rumbletech/Slug_v1.0/README.md

# Slug_v1.0
Slug ( Slog/Serial Logger ) is an open source firmware and an open source hardware project , it implements logging of serial buses like USART,I2C,SPI to an SD Card.
