rumbletech/Slug_v1.0/kicad/prj/slug_v1_0.kicad_pcb

## KiCad design kicad/prj/slug_v1_0.kicad_pcb (2025-04-25)

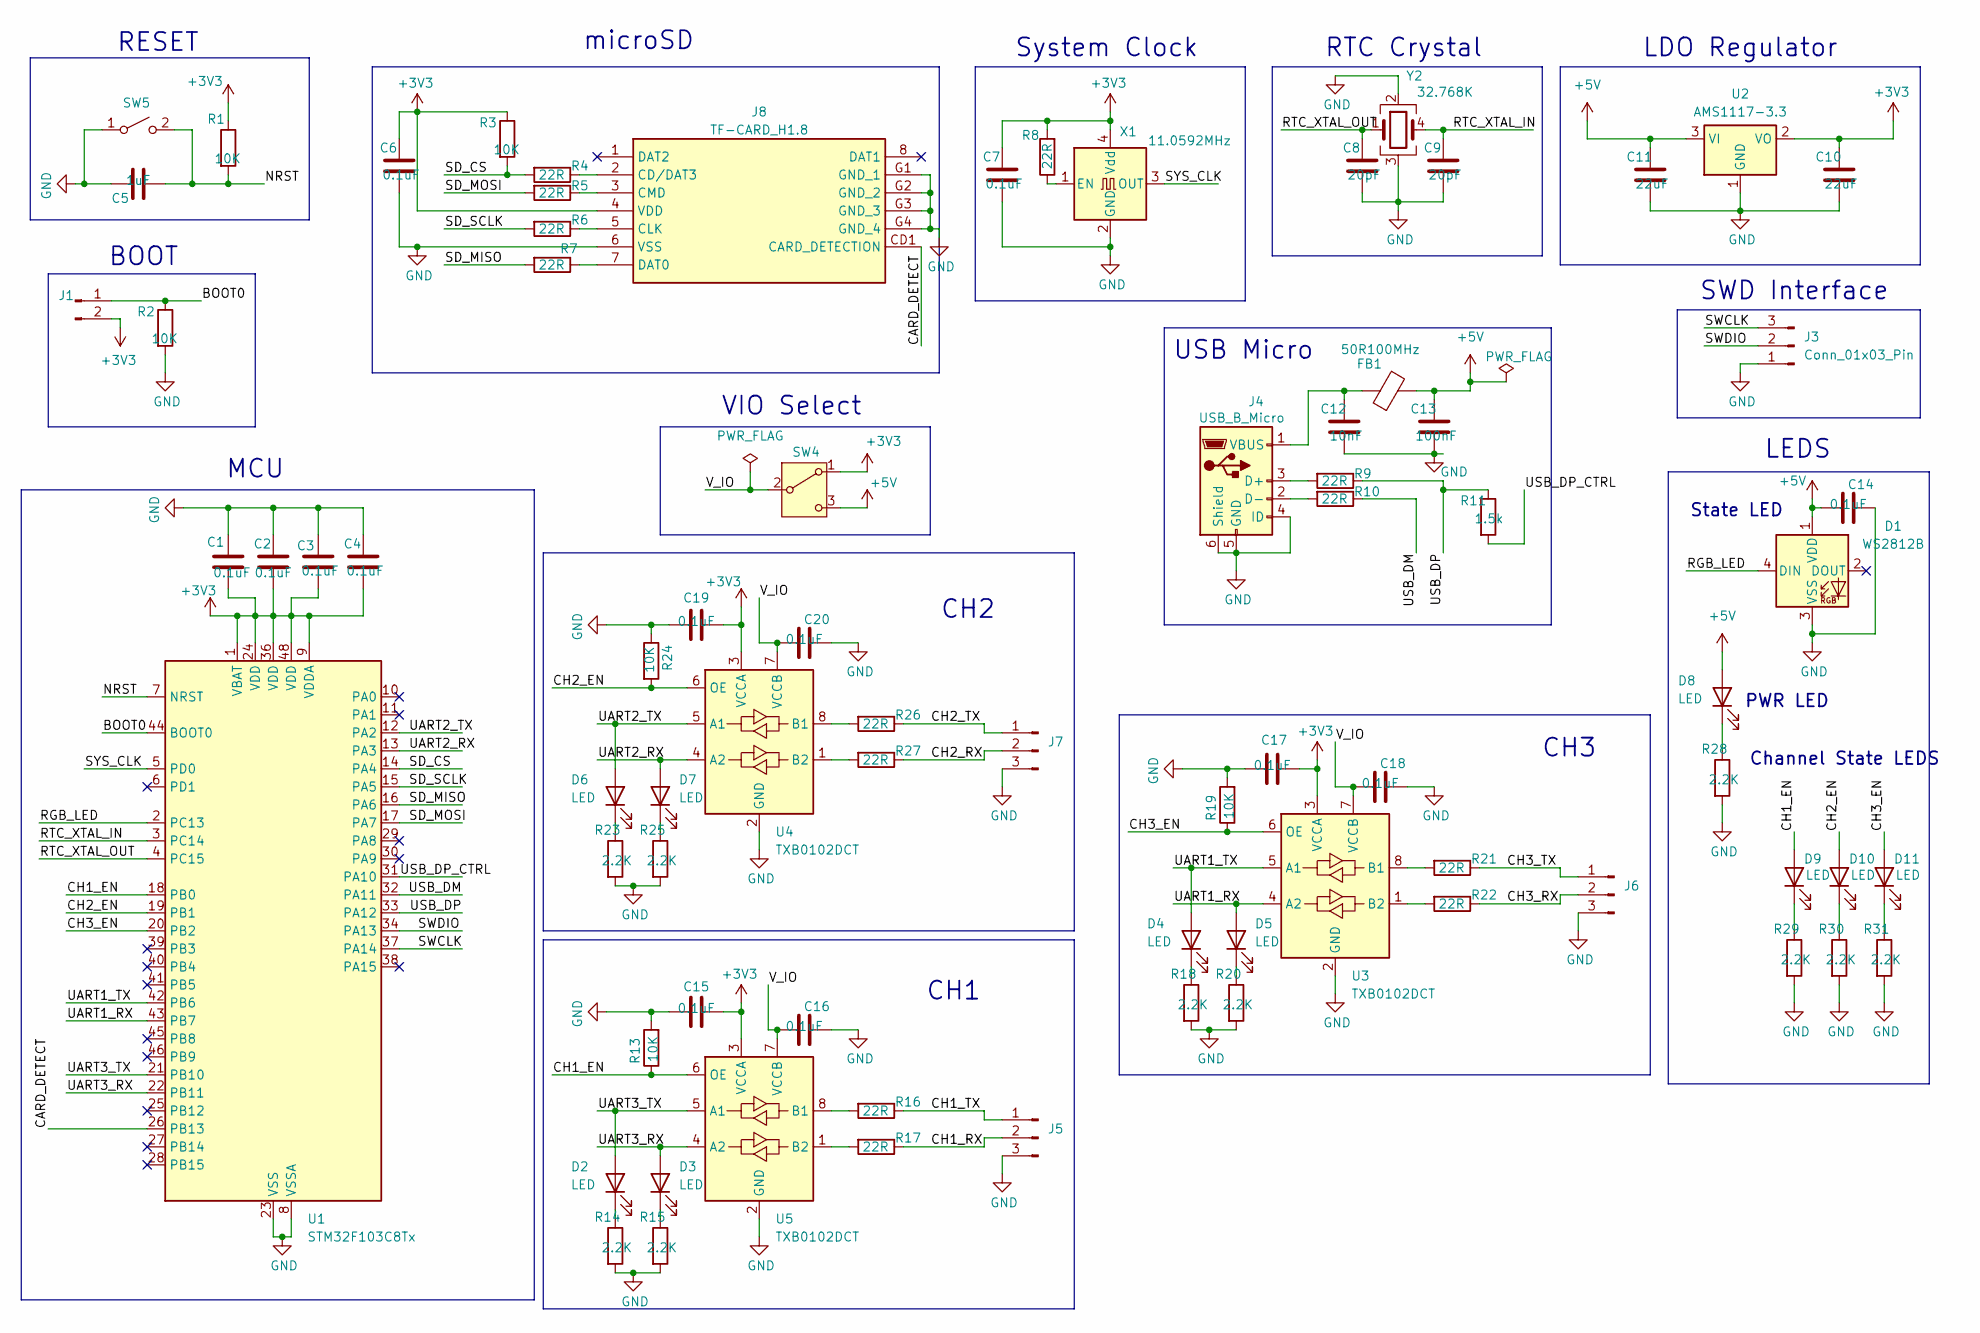
[picture p1: schematic slug_v1_0.kicad_sch]

Parts:
C1, C2, C3, C4, C6, C7, C14, C15, C16, C17, C18, C19, C20: 0.1uF; C_0805_2012Metric
C5: 1uF; C_0805_2012Metric
C8, C9: 20pF; C_0805_2012Metric
C10, C11: 22uF; C_0805_2012Metric
C12: 10nF; C_0805_2012Metric
C13: 100nF; C_0805_2012Metric
D1: WS2812B; LED_WS2812B_PLCC4_5.0x5.0mm_P3.2mm
D2, D3, D4, D5, D6, D7, D8, D9, D10, D11: LED; LED_0805_2012Metric
FB1: 50R100MHz; L_0805_2012Metric
J1: Conn_01x02_Pin; PinHeader_1x02_P2.54mm_Vertical
J3: Conn_01x03_Pin; PinHeader_1x03_P2.54mm_Vertical
J4: USB_B_Micro; USB_Micro-B_Amphenol_10118193-0001LF_Horizontal
J5, J6, J7: Conn_01x03_Pin; PinHeader_1x03_P2.54mm_Horizontal
J8: TF-CARD_H1.8; TFCARDH18; Manufacturer_Part_Number TF-CARD H1.8
R1, R2, R3, R13, R19, R24: 10K; R_0805_2012Metric
R4, R5, R6, R7, R8, R9, R10, R16, R17, R21, R22, R26, R27: 22R; R_0805_2012Metric
R11: 1.5k; R_0805_2012Metric
R14, R15, R18, R20, R23, R25, R28, R29, R30, R31: 2.2K; R_0805_2012Metric
SW4: SW_SPDT; SW_SPDT_CK_JS102011SAQN
SW5: SW_SPST; SW_SPST_SKQG_WithStem
U1: STM32F103C8Tx; LQFP-48_7x7mm_P0.5mm
U2: AMS1117-3.3; SOT-223-3_TabPin2
U3, U4, U5: TXB0102DCT; TSSOP-8_3x3mm_P0.65mm
X1: 11.0592MHz; Crystal_SMD_7050-4Pin_7.0x5.0mm
Y2: 32.768K; Crystal_SMD_SeikoEpson_MC306-4Pin_8.0x3.2mm

Connections:
+3V3: C1.2, C2.2, C3.2, C4.2, C6.1, C7.1, C10.1, C15.2, C17.2, C19.2, J1.2, J8.4 (VDD), R1.1, R3.1, R8.2, SW4.1 (A), U1.1 (VBAT), U1.9 (VDDA), U1.24 (VDD), U1.36 (VDD), U1.48 (VDD), U2.2 (VO), U3.3 (VCCA), U4.3 (VCCA), U5.3 (VCCA), X1.4 (Vdd)
+5V: C11.1, C13.1, C14.1, D1.1 (VDD), D8.2 (A), FB1.2, SW4.3 (C), U2.3 (VI)
/BOOT0: J1.1, R2.1, U1.44 (BOOT0)
/CARD_DETECT: J8.CD1 (CARD_DETECTION), U1.26 (PB13)
/CH1_EN: D9.2 (A), R13.1, U1.18 (PB0), U5.6 (OE)
/CH1_RX: J5.2, R17.1
/CH1_TX: J5.1, R16.1
/CH2_EN: D10.2 (A), R24.2, U1.19 (PB1), U4.6 (OE)
/CH2_RX: J7.2, R27.1
/CH2_TX: J7.1, R26.1
/CH3_EN: D11.2 (A), R19.1, U1.20 (PB2), U3.6 (OE)
/CH3_RX: J6.2, R22.1
/CH3_TX: J6.1, R21.1
/NRST: C5.2, R1.2, SW5.2 (B), U1.7 (NRST)
/RGB_LED: D1.4 (DIN), U1.2 (PC13)
/RTC_XTAL_IN: C9.1, U1.3 (PC14), Y2.4
/RTC_XTAL_OUT: C8.1, U1.4 (PC15), Y2.1
/SD_CS: R3.2, R4.2, U1.14 (PA4)
/SD_MISO: R7.2, U1.16 (PA6)
/SD_MOSI: R5.2, U1.17 (PA7)
/SD_SCLK: R6.2, U1.15 (PA5)
/SWCLK: J3.3, U1.37 (PA14)
/SWDIO: J3.2, U1.34 (PA13)
/SYS_CLK: U1.5 (PD0), X1.3 (OUT)
/UART1_RX: D5.2 (A), U1.43 (PB7), U3.4 (A2)
/UART1_TX: D4.2 (A), U1.42 (PB6), U3.5 (A1)
/UART2_RX: D7.2 (A), U1.13 (PA3), U4.4 (A2)
/UART2_TX: D6.2 (A), U1.12 (PA2), U4.5 (A1)
/UART3_RX: D3.2 (A), U1.22 (PB11), U5.4 (A2)
/UART3_TX: D2.2 (A), U1.21 (PB10), U5.5 (A1)
/USB_DM: R10.1, U1.32 (PA11)
/USB_DP: R9.1, R11.1, U1.33 (PA12)
/USB_DP_CTRL: R11.2, U1.31 (PA10)
/V_IO: C16.1, C18.1, C20.1, SW4.2 (B), U3.7 (VCCB), U4.7 (VCCB), U5.7 (VCCB)
GND: C1.1, C2.1, C3.1, C4.1, C5.1, C6.2, C7.2, C8.2, C9.2, C10.2, C11.2, C12.2, C13.2, C14.2, C15.1, C16.2, C17.1, C18.2, C19.1, C20.2, D1.3 (VSS), J3.1, J4.4 (ID), J4.5 (GND), J4.6 (Shield), J5.3, J6.3, J7.3, J8.6 (VSS), J8.G1 (GND_1), J8.G2 (GND_2), J8.G3 (GND_3), J8.G4 (GND_4), R2.2, R13.2, R14.2, R15.2, R18.2, R19.2, R20.2, R23.2, R24.1, R25.2, R28.2, R29.2, R30.2, R31.2, SW5.1 (A), U1.8 (VSSA), U1.23 (VSS), U1.35 (VSS), U1.47 (VSS), U2.1 (GND), U3.2 (GND), U4.2 (GND), U5.2 (GND), X1.2 (GND), Y2.2, Y2.3
unnamed: D2.1 (K), R14.1
unnamed: D3.1 (K), R15.1
unnamed: D4.1 (K), R18.1
unnamed: D5.1 (K), R20.1
unnamed: D6.1 (K), R23.1
unnamed: D7.1 (K), R25.1
unnamed: D8.1 (K), R28.1
unnamed: D9.1 (K), R29.1
unnamed: D10.1 (K), R30.1
unnamed: D11.1 (K), R31.1
unnamed: J4.3 (D+), R9.2
unnamed: J4.2 (D-), R10.2
unnamed: C12.1, FB1.1, J4.1 (VBUS)
unnamed: J8.2 (CD/DAT3), R4.1
unnamed: J8.5 (CLK), R6.1
unnamed: J8.3 (CMD), R5.1
unnamed: J8.7 (DAT0), R7.1
unnamed: R21.2, U3.8 (B1)
unnamed: R22.2, U3.1 (B2)
unnamed: R26.2, U4.8 (B1)
unnamed: R27.2, U4.1 (B2)
unnamed: R16.2, U5.8 (B1)
unnamed: R17.2, U5.1 (B2)
unnamed: R8.1, X1.1 (EN)

Notes on the sheet:
State LED
MCU
CH1
RTC Crystal
CH2
System Clock
microSD
CH3
LDO Regulator
RESET
USB Micro
Channel State LEDS
BOOT
VIO Select
PWR LED
SWD Interface
LEDS

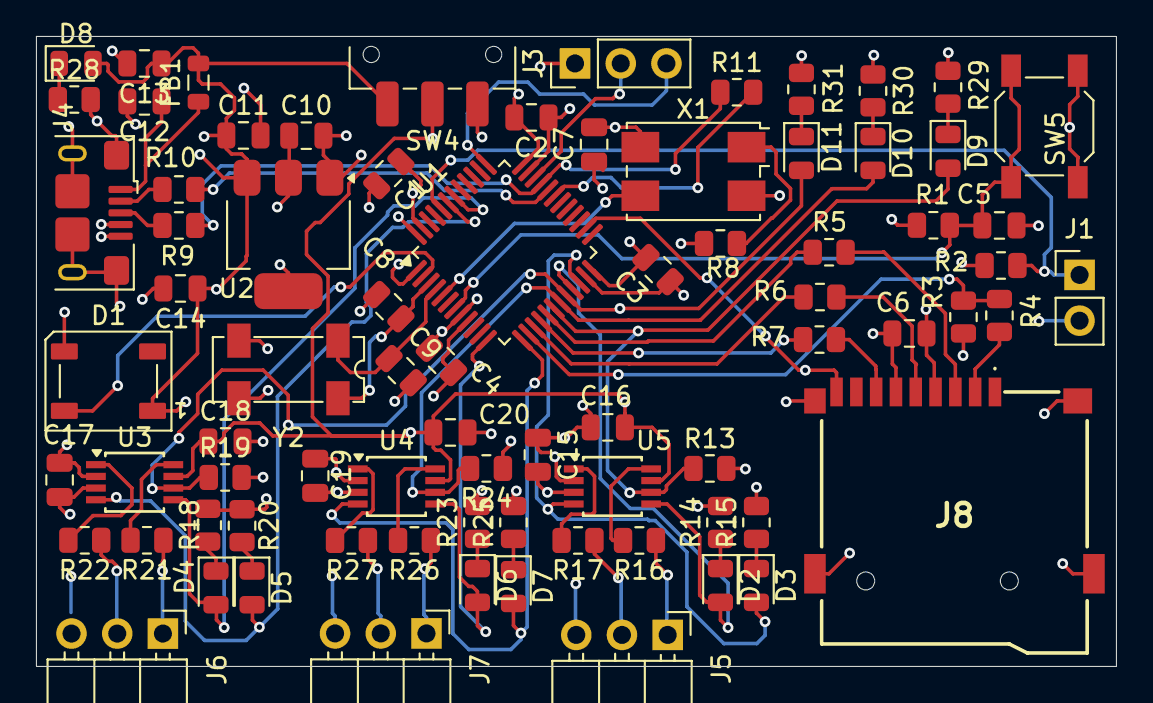
[picture p2: board slug_v1_0.kicad_pcb from above]

Board: 4 copper layers, 60.0 x 35.0 mm, 78 parts (0 on the bottom side), 59 nets.
