rumbletech/Slug_v1.0/cube/Slug_v1.ioc

Mcu.UserName=STM32F103CBTx
PA10.Signal=GPIO_Output
PA11.Signal=USB_DM
PA12.Signal=USB_DP
PA13.Signal=SYS_JTMS-SWDIO
PA14.Signal=SYS_JTCK-SWCLK
PA2.Signal=USART2_TX
PA3.Signal=USART2_RX
PA4.Signal=SPI1_NSS
PA5.Signal=SPI1_SCK
PA6.Signal=SPI1_MISO
PA7.Signal=SPI1_MOSI
PB0.Signal=GPIO_Output
PB1.Signal=GPIO_Output
PB10.Signal=USART3_TX
PB11.Signal=USART3_RX
PB2.Signal=GPIO_Output
PB3.Signal=GPIO_Output
PB4.Signal=GPIO_Output
PB5.Signal=GPIO_Output
PB6.Signal=USART1_TX
PB7.Signal=USART1_RX
PC14-OSC32_IN.Signal=RCC_OSC32_IN
PC15-OSC32_OUT.Signal=RCC_OSC32_OUT
PD0-OSC_IN.Signal=RCC_OSC_IN
PD1-OSC_OUT.Signal=RCC_OSC_OUT
