rumbletech/Slug_v1.0/cube/Core/Inc/fsmt.h

/*
 * fsmt.h
 *
 *  Created on: Jun 21, 2025
 *      Author: rumbl
 */

#ifndef INC_FSMT_H_
#define INC_FSMT_H_

#define FSM_CYCLE_DURATION_MS 10U

extern void fsm_init( void );
extern void fsm ( void );

#endif /* INC_FSMT_H_ */
