rumbletech/Slug_v1.0/(commit log)

2024-10-05 Fix HSE Freq to 8MHz , Add Printf Example.
    [Slug_v1.ioc, common.h]
2024-10-06 Add Fatfs lib , GPIO handle , SPI1 and SDC driver.
2025-04-20 Add RGB module and fix compilation errors.
    [SDCD.c, rgb.c, rgb.h]
2025-04-25 Added Kicad project files , bom and gerbers and major fw update.
    - Added USB Device lib.
    - changes part to STM32F103CBT6 (128kb flash).
    - Added drivers for rgb led and channel enable pins.
    - Added JSMN jason parser.
    - Added working small app to read json configuration and configure
    channels.
    [bom.csv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]
2025-05-05 Working UART IRQ
    TBD:
    - Move to light weight SPI driver.
    - Move to light weight UART driver.
    - Move to light weight GPIO driver.
    - Move to tinyusb + freeRTOS instead of HAL.
2025-05-12 Removed USB Device.
2025-05-12 - Updates.
    - Added lwDriver instead of HAL.
    - Added GPIO/SPI/RCC Drivers.
    - Added BSP and self contained modules.
    - Remove redundant module SDC_SPI.c
    - TBD : SPI PIN AF Add to lw_gpio.
    - TBD : Make clock configuration in lw_rcc
2025-05-18 - Removed Dependency on HAL_SPI and HAL_GPIO on SDCD Module.
    - Fixed BSP MOSI pin number.
    - Added GPIO Mode and CFG to lwGPIO.
    [SDCD.c, SDCD.h, bsp.h, lw_gpio.c, lw_gpio.h, lw_rcc.c, lw_rcc.h]
2025-05-30 Remove HAL_UART dependency and add lw_UART driver.
2025-06-13 Rework Com_Channel module , add final lwDrivers , add clock init.
    remove file_sys module and move logic to application.
    [com_channel.c, com_channel.h, common.h, sfifo.c, sfifo.h]
2025-06-14 Add TickHook to RTOS , remove driver to driver dependencies and move init to system init function.
2025-06-26 Add FSM and DISK thread handlers.
2025-06-28 First Working SDC Variant
    - Added Automatic writing and flushing io operations.
    - Replaced fifo with ping pong buffers.
    - Write Cyclicity to 100 ms
    - Flush Cyclicity to 1s.
    [SDCD.c, com_channel.c, com_channel.h, common.h, diskt.c, diskt.h, fsmt.c, lw_uart.c]
